Thiru2006/bjt-programmable-gain-amplifier/Circuit/BJT-PGA.asc

C1: cap; 47p
C2: cap; 10µ
Q1: pnp; BC557B
Q2: pnp; BC557B
Q3: npn; BC547B
Q4: npn; BC547B
Q5: npn; BC547B
Q6: npn; BC547B
Q7: npn; BC547B
Q8: npn; BC547B
Q9: npn; BC547B
R1: res; 10k
R2: res; 10k
R3: res; 1k
R4: res; 100k
R5: res; 100k
R6: res; 100k
R7: res; 47k
R8: res; 25k
R9: res; 100
R10: res; 4.7k
R11: res; 4.7k
R12: res; 4.7k
V1: voltage; 12
V2: voltage; SINE(0 100m 1k); AC 1
V3: voltage; -12
V4: voltage; {B0}
V5: voltage; {B1}
V6: voltage; {B2}
Named nets: 0, VOUT, Vin
.tran 10m
.ac dec 100 1 1Meg
.param code=0
.param B0=if(mod(code,2),5,0)
.param B1=if(mod(floor(code/2),2),5,0)
.param B2=if(mod(floor(code/4),2),5,0)
 
.step param code 0 7 1
