Thiru2006/bjt-programmable-gain-amplifier/Hardware/Step-1.jpeg

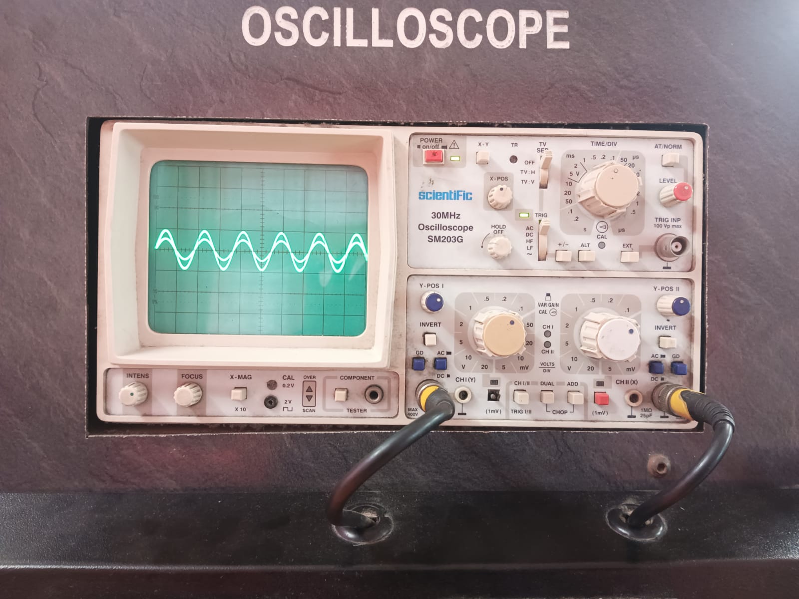
Hardware/Step-1.jpeg
