Thiru2006/bjt-programmable-gain-amplifier/Hardware/Step-2.jpeg

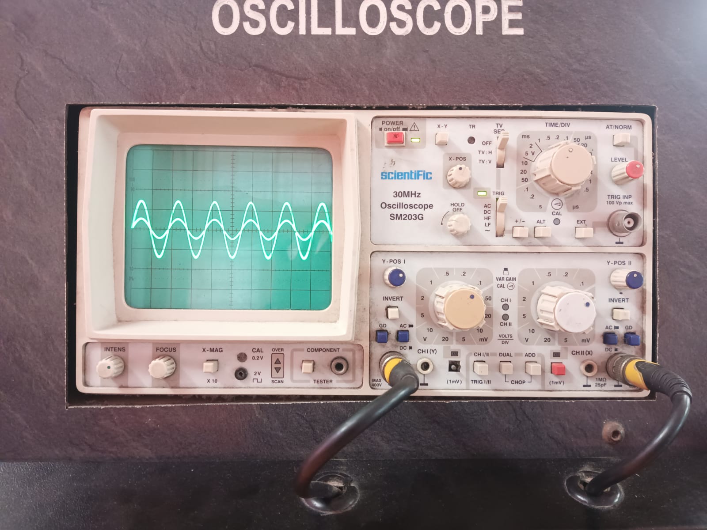
Hardware/Step-2.jpeg
