Thiru2006/bjt-programmable-gain-amplifier/Hardware/Step-4.jpeg

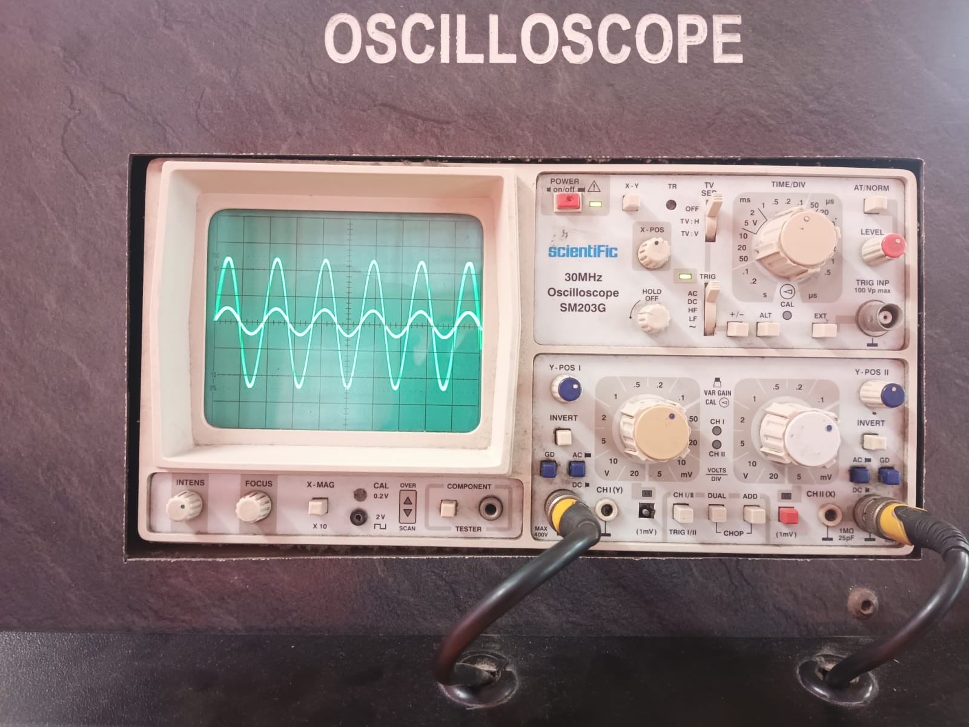
Hardware/Step-4.jpeg
